ketszim97/USB_PD_Source/USB_PD_Source.pdf

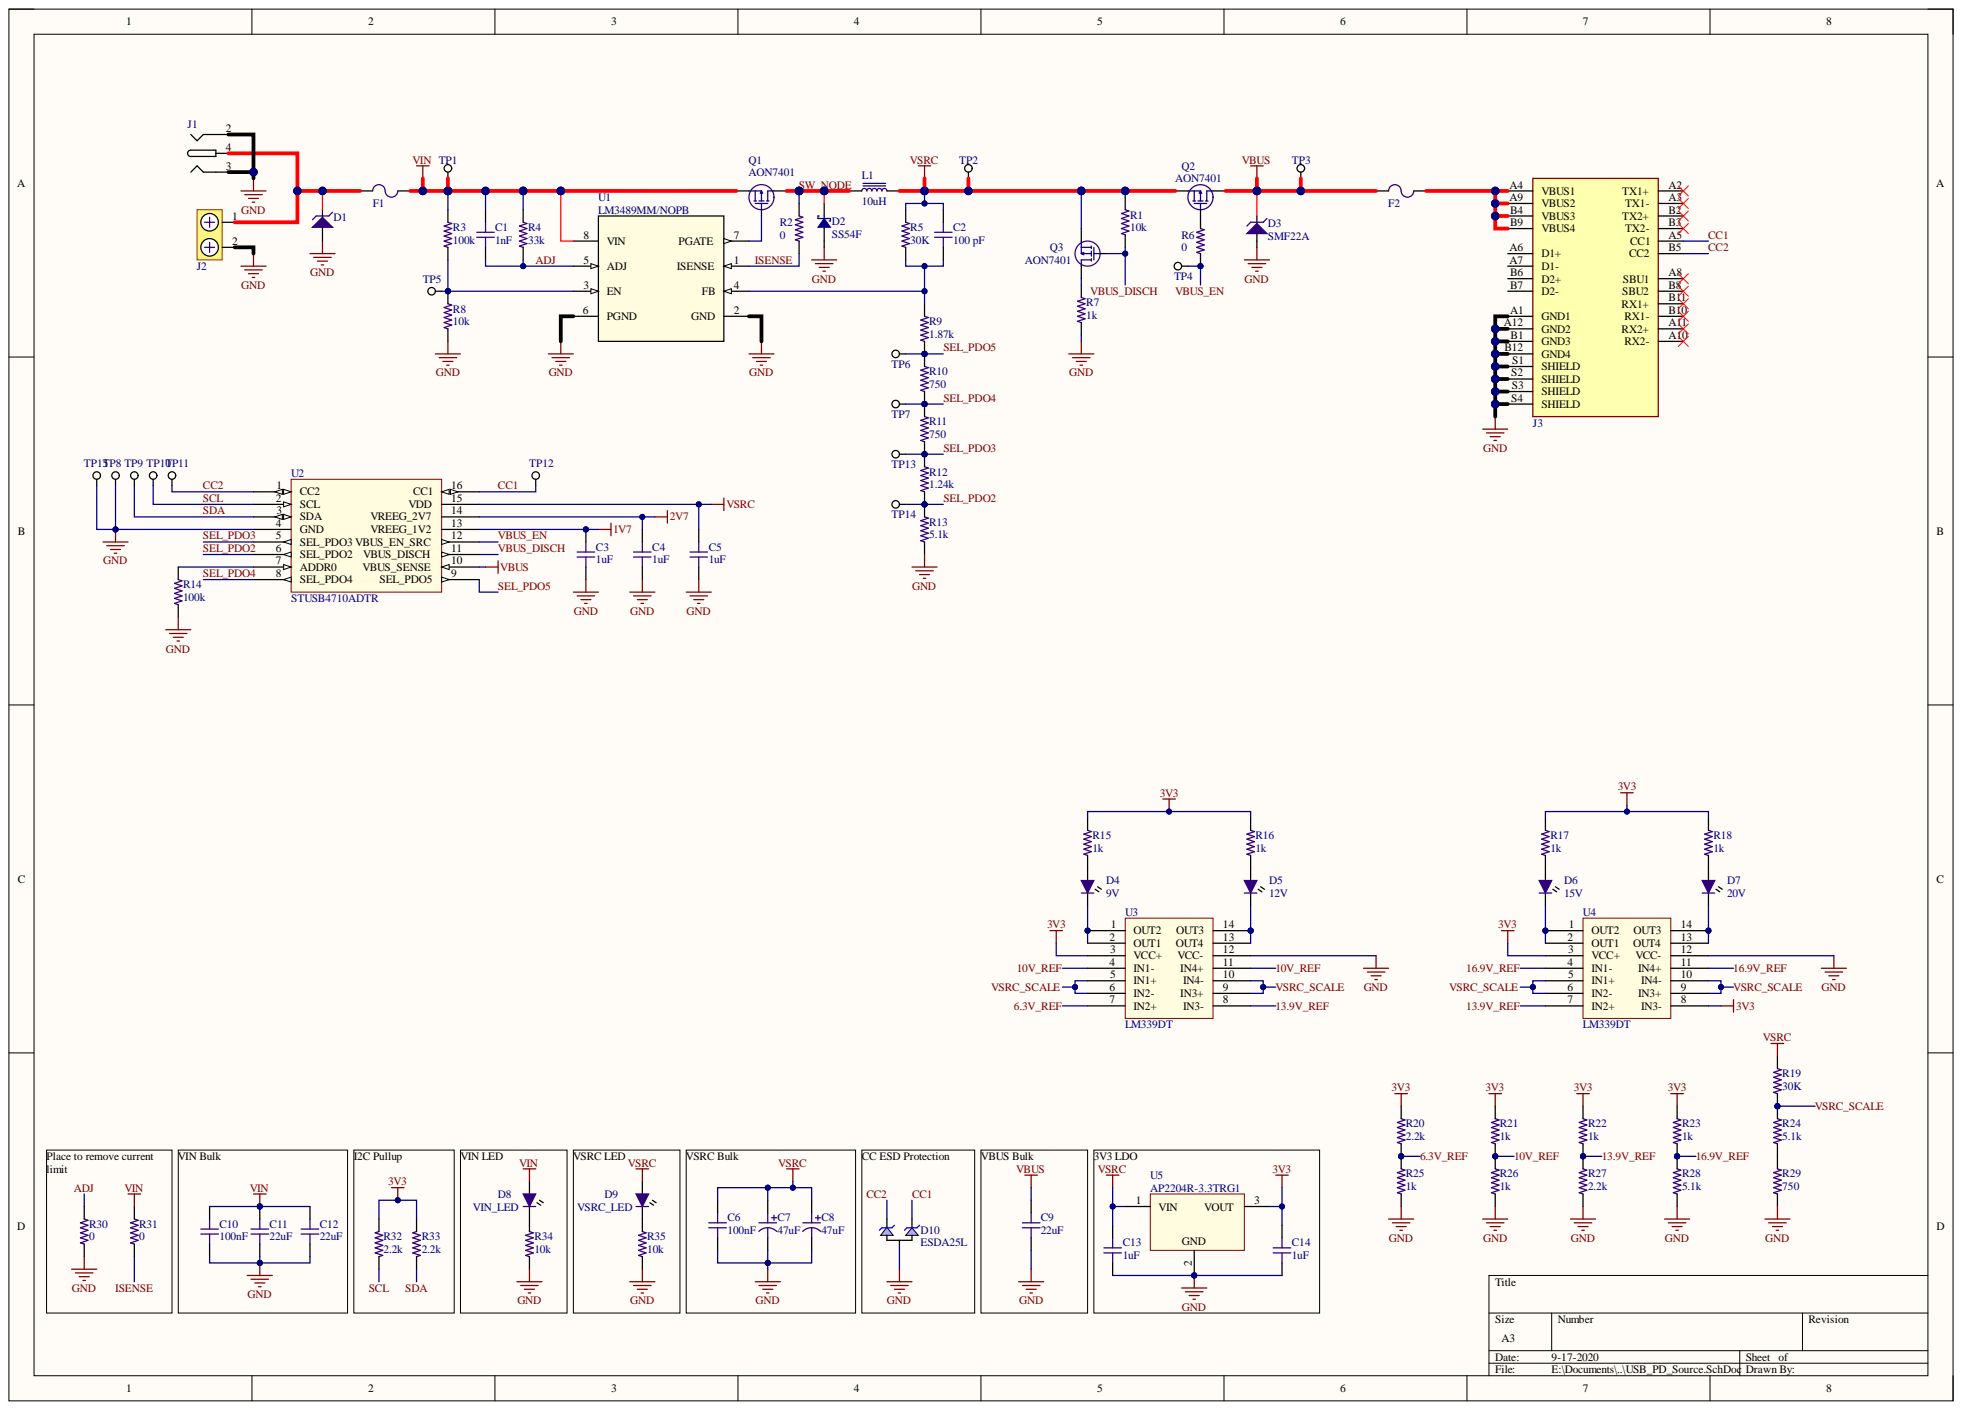
[picture p1: page 1]

Place to remove current
limit
ADJ

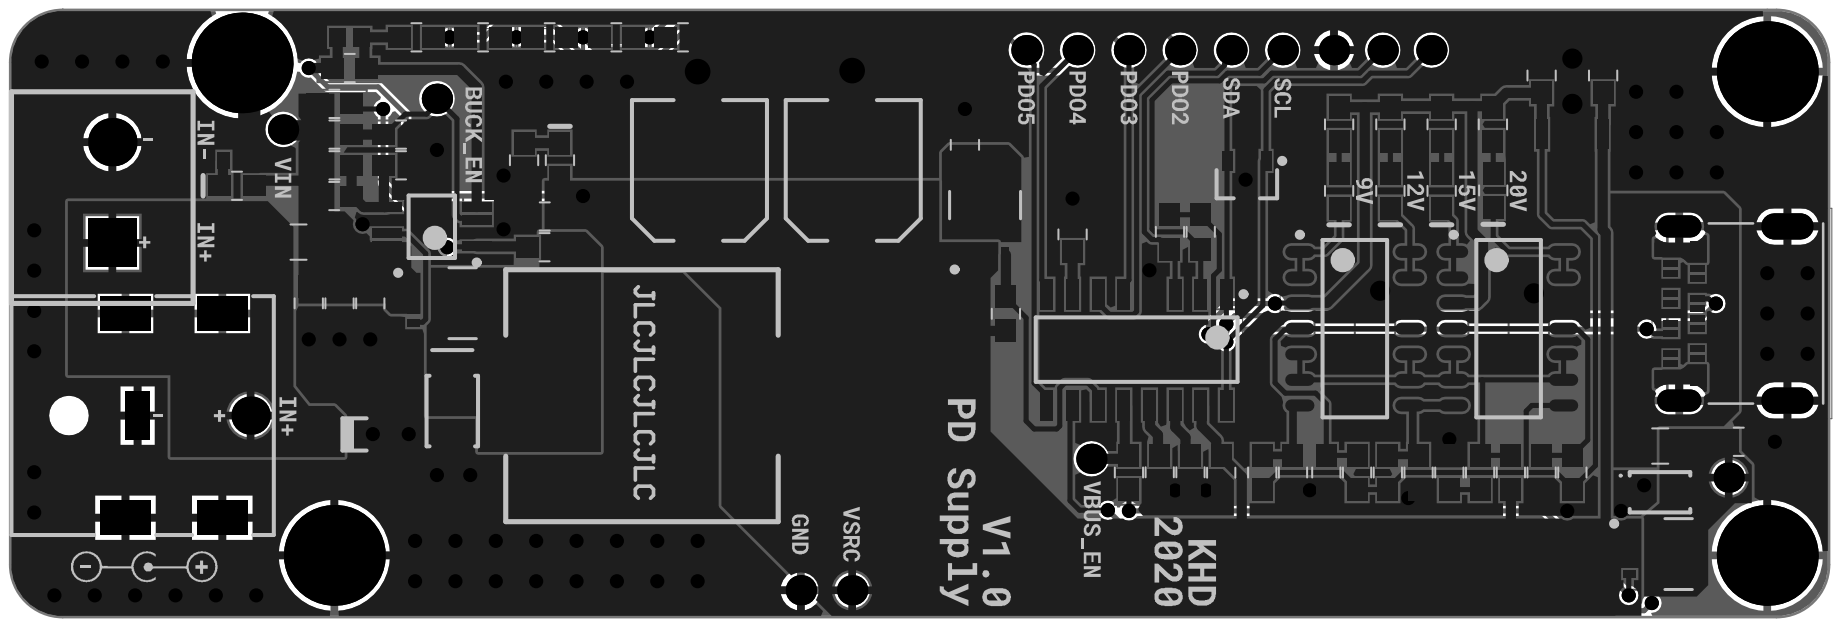
[picture p2: page 2]

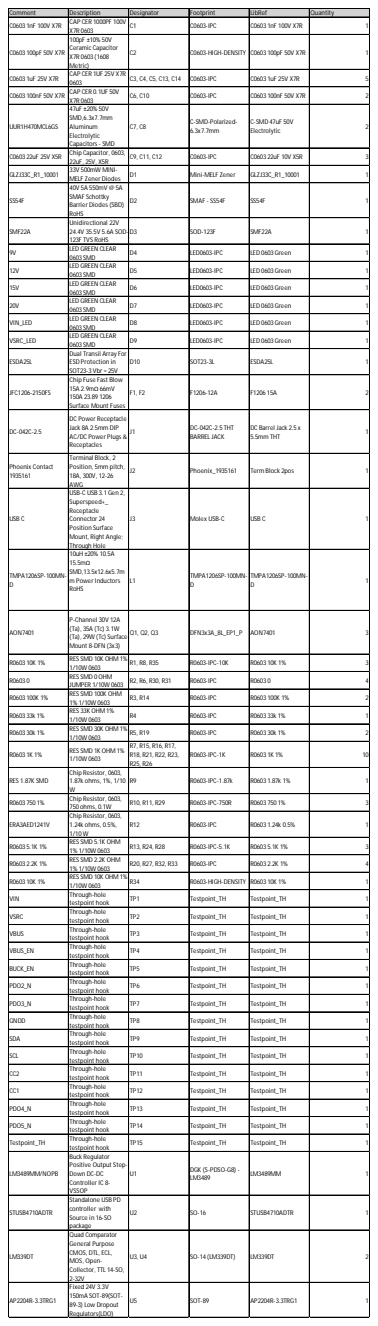
[picture p3: page 3]

C0603 100pF 50V X7R | 100pF ±10% 50V Ceramic Capacitor X7R 0603 (1608 Metric) | C2 | C0603-HIGH-DENSITY | C0603 100pF 50V X7R | 1

C0603 1uF 25V X7R | CAP CER 1UF 25V X7R 0603 | C3, C4, C5, C13, C14 | C0603-IPC | C0603 1uF 25V X7R | 5

C0603 100nF 50V X7R | CAP CER 0.1UF 50V X7R 0603 | C6, C10 | C0603-IPC | C0603 100nF 50V X7R | 2

UUR1H470MCL6GS | 47uF ±20% 50V SMD,6.3x7.7mm Aluminum Electrolytic Capacitors - SMD | C7, C8 | C-SMD-Polarized-6.3x7.7mm | C-SMD 47uF 50V Electrolytic | 2

C0603 22uF 25V X5R | Chip Capacitor, 0603, 22uF, 25V, X5R | C9, C11, C12 | C0603-IPC | C0603 22uF 10V X5R | 3

GLZJ33C_R1_10001 | 33V 500mW MINI-MELF Zener Diodes | D1 | Mini-MELF Zener | GLZJ33C_R1_10001 | 1

SS54F | 40V 5A 550mV @ 5A SMAF Schottky Barrier Diodes (SBD) RoHS | D2 | SMAF - SS54F | SS54F | 1

SMF22A | Unidirectional 22V 24.4V 35.5V 5.6A SOD-123F TVS RoHS | D3 | SOD-123F | SMF22A | 1

9V | LED GREEN CLEAR 0603 SMD | D4 | LED0603-IPC | LED 0603 Green | 1

12V | LED GREEN CLEAR 0603 SMD | D5 | LED0603-IPC | LED 0603 Green | 1

15V | LED GREEN CLEAR 0603 SMD | D6 | LED0603-IPC | LED 0603 Green | 1

20V | LED GREEN CLEAR 0603 SMD | D7 | LED0603-IPC | LED 0603 Green | 1

VIN_LED | LED GREEN CLEAR 0603 SMD | D8 | LED0603-IPC | LED 0603 Green | 1

VSRC_LED | LED GREEN CLEAR 0603 SMD | D9 | LED0603-IPC | LED 0603 Green | 1

ESDA25L | Dual Transil Array For ESD Protection in SOT23-3 Vbr = 25V | D10 | SOT23-3L | ESDA25L | 1

JFC1206-2150FS | Chip Fuse Fast Blow 15A 2.9mΩ 66mV 150A 23.89 1206 Surface Mount Fuses | F1, F2 | F1206-12A | F1206 15A | 2

DC-042C-2.5 | DC Power Receptacle Jack 8A 2.5mm DIP AC/DC Power Plugs & Receptacles | J1 | DC-042C-2.5 THT BARREL JACK | DC Barrel Jack 2.5 x 5.5mm THT | 1

Phoenix Contact 1935161 | Terminal Block, 2 Position, 5mm pitch, 18A, 300V, 12-26 AWG | J2 | Phoenix_1935161 | Term Block 2pos | 1

USB C | USB-C USB 3.1 Gen 2, Superspeed+_ Receptacle Connector 24 Position Surface Mount, Right Angle; Through Hole | J3 | Molex USB-C | USB C | 1

TMPA1206SP-100MN-D | 10uH ±20% 10.5A 15.5mΩ SMD,13.5x12.6x5.7m m Power Inductors RoHS | L1 | TMPA1206SP-100MN-D | TMPA1206SP-100MN-D | 1

AON7401 | P-Channel 30V 12A (Ta), 35A (Tc) 3.1W (Ta), 29W (Tc) Surface Mount 8-DFN (3x3) | Q1, Q2, Q3 | DFN3x3A_8L_EP1_P | AON7401 | 3

R0603 10K 1% | RES SMD 10K OHM 1% 1/10W 0603 | R1, R8, R35 | R0603-IPC-10K | R0603 10K 1% | 3

R0603 0 | JUMPER 1/10W 0603 RES SMD 0OHM | R2, R6, R30, R31 | R0603-IPC | R0603 0 | 4

R0603 100K 1% | RES SMD 100K OHM 1% 1/10W 0603 | R3, R14 | R0603-IPC | R0603 100K 1% | 2

R0603 33k 1% | RES 33K OHM 1% 1/10W 0603 | R4 | R0603-IPC | R0603 33k 1% | 1

R0603 30k 1% | RES SMD 30K OHM 1% 1/10W 0603 | R5, R19 | R0603-IPC | R0603 30k 1% | 2

R0603 1K 1% | RES SMD 1K OHM 1% 1/10W 0603 | R7, R15, R16, R17, R18, R21, R22, R23, R25, R26 | R0603-IPC-1K | R0603 1K 1% | 10

RES 1.87K SMD | Chip Resistor, 0603, 1.87k ohms, 1%, 1/10 W | R9 | R0603-IPC-1.87k | R0603 1.87k 1% | 1

R0603 750 1% | Chip Resistor, 0603, 750 ohms, 0.1W | R10, R11, R29 | R0603-IPC-750R | R0603 750 1% | 3

ERA3AED1241V | Chip Resistor, 0603, 1.24k ohms, 0.5%, 1/10 W | R12 | R0603-IPC | R0603 1.24k 0.5% | 1

R0603 5.1K 1% | RES SMD 5.1K OHM 1% 1/10W 0603 | R13, R24, R28 | R0603-IPC-5.1K | R0603 5.1K 1% | 3

R0603 2.2K 1% | RES SMD 2.2K OHM 1% 1/10W 0603 | R20, R27, R32, R33 | R0603-IPC | R0603 2.2K 1% | 4

R0603 10K 1% | RES SMD 10K OHM 1% 1/10W 0603 | R34 | R0603-HIGH-DENSITY | R0603 10K 1% | 1

VIN | Through-hole testpoint hook | TP1 | Testpoint_TH | Testpoint_TH | 1

VSRC | Through-hole testpoint hook | TP2 | Testpoint_TH | Testpoint_TH | 1

VBUS | Through-hole testpoint hook | TP3 | Testpoint_TH | Testpoint_TH | 1

VBUS_EN | Through-hole testpoint hook | TP4 | Testpoint_TH | Testpoint_TH | 1

BUCK_EN | Through-hole testpoint hook | TP5 | Testpoint_TH | Testpoint_TH | 1

PDO2_N | Through-hole testpoint hook | TP6 | Testpoint_TH | Testpoint_TH | 1

PDO3_N | Through-hole testpoint hook | TP7 | Testpoint_TH | Testpoint_TH | 1

GNDD | Through-hole testpoint hook | TP8 | Testpoint_TH | Testpoint_TH | 1

SDA | Through-hole testpoint hook | TP9 | Testpoint_TH | Testpoint_TH | 1

SCL | Through-hole testpoint hook | TP10 | Testpoint_TH | Testpoint_TH | 1

CC2 | Through-hole testpoint hook | TP11 | Testpoint_TH | Testpoint_TH | 1

CC1 | Through-hole testpoint hook | TP12 | Testpoint_TH | Testpoint_TH | 1

PDO4_N | Through-hole testpoint hook | TP13 | Testpoint_TH | Testpoint_TH | 1

PDO5_N | Through-hole testpoint hook | TP14 | Testpoint_TH | Testpoint_TH | 1

Testpoint_TH | Through-hole testpoint hook | TP15 | Testpoint_TH | Testpoint_TH | 1

LM3489MM/NOPB | Buck Regulator Positive Output Step-Down DC-DC Controller IC 8-VSSOP | U1 | DGK (S-PDSO-G8) -LM3489 | LM3489MM | 1

STUSB4710ADTR | Standalone USB PD controller with Source in 16-SO package | U2 | SO-16 | STUSB4710ADTR | 1

LM339DT | Quad Comparator General Purpose CMOS, DTL, ECL, MOS, Open-Collector, TTL 14-SO, 2-32V | U3, U4 | SO-14 (LM339DT) | LM339DT | 2

AP2204R-3.3TRG1 | Fixed 24V 3.3V 150mA SOT-89(SOT-89-3) Low Dropout Regulators(LDO) | U5 | SOT-89 | AP2204R-3.3TRG1 | 1
