ketszim97/USB_PD_Source/(list of files, drawings)

Other design files:
USB_PD_Source.PcbDoc
USB_PD_Source.PrjPcb
USB_PD_Source.SchDoc
