ketszim97/USB_PD_Source/(commit log)

2020-08-19 Add project files and gitignore
    [USB_PD_Source.PcbDoc, USB_PD_Source.PrjPcb, USB_PD_Source.SchDoc]
2020-08-26 Remove IC
    [USB_PD_Source.SchDoc]
2020-09-02 Added LM3489 switcher, added STUSB begun schematicAdded LM3489 switcher, added STUSB begun schematic
    [USB_PD_Source.SchDoc]
2020-09-03 Add circuit protection, input and output connectors
    [USB_PD_Source.SchDoc]
2020-09-04 Add LED indication, feedback network, fusesAdd LED indication, feedback network, fuses
    [USB_PD_Source.SchDoc]
2020-09-04 Add individual PDO LED lightingAdd individual PDO LED lighting
    [USB_PD_Source.SchDoc]
2020-09-04 Complete SCHComplete SCH
    [USB_PD_Source.SchDoc]
2020-09-05 Initial part placementInitial part placement
    [USB_PD_Source.SchDoc]
2020-09-05 Completed first pass at routingCompleted first pass at routing
    [USB_PD_Source.SchDoc]
2020-09-06 Fix stitching via connect style. Add rendersFix stitching via connect style. Add renders
    [USB_PD_Source.PrjPcb]
2020-09-07 Complete silk screen and add gerbersComplete silk screen and add gerbers
    [USB_PD_Source.GBL, USB_PD_Source.GBO, USB_PD_Source.GBS, USB_PD_Source.GKO, USB_PD_Source.GM1, USB_PD_Source.GTL, USB_PD_Source.GTO, USB_PD_Source.GTP]
2020-09-07 Add JLCJLC to silkscreenAdd JLCJLC to silkscreen
    [USB_PD_Source.GBL, USB_PD_Source.GBO, USB_PD_Source.GBS, USB_PD_Source.GKO, USB_PD_Source.GM1, USB_PD_Source.GTL, USB_PD_Source.GTO, USB_PD_Source.GTP]
2020-10-27 Update gitignore. Fix Bugs
    [USB_PD_Source.PrjPcb, USB_PD_Source.SchDoc]
